datkinson/dissertation/report/Images/ir.jpg

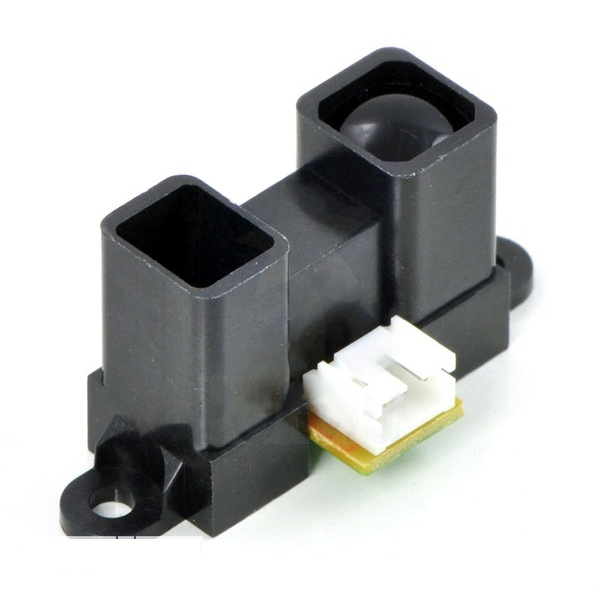
report/Images/ir.jpg
