datkinson/dissertation/report/Images/lr-ir.jpg

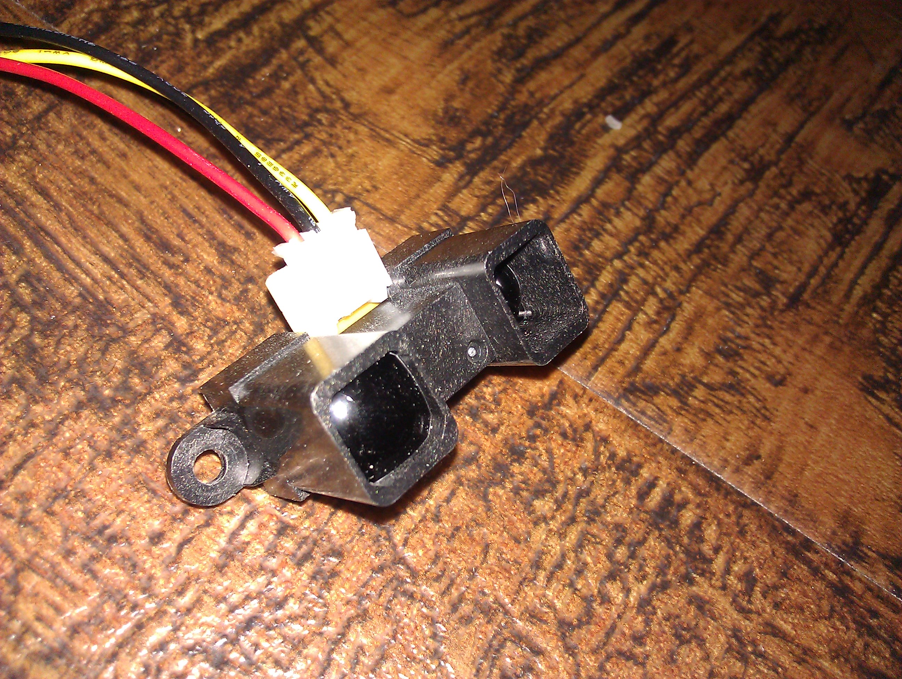
report/Images/lr-ir.jpg
