datkinson/dissertation/README.md

dissertation
============

Final year project
