datkinson/dissertation/report/abstract.tex

\thispagestyle{empty}

\begin{center}
    {\LARGE\bf Abstract}
\end{center}
The aim of this project is to physically build and write the software for a robot.  This robot should be able to drive around within its environment under its own power without colliding with any obstruction.  It should also be able to see areas of the environment using some form of sensor system in order to determine which direction to travel safely.
