datkinson/dissertation/report/Appendix2/appendix2.tex

\chapter{Code samples}

\section{Motor control}
Motors moving forward using stepper library and h-bridge.
\lstinputlisting{Code/motors-old.cpp}

Motors moving forward using replacement Pololu stepper drivers.
\lstinputlisting{Code/motors-new.cpp}

\section{Sonar}
Trigger and echo control of the sonar sensors.
\lstinputlisting{Code/sonar.cpp}
