datkinson/dissertation/report/cover.tex

\title{Arduino Based Obstacle Avoidance Robot}

% Your name
\author{Daniel Atkinson}

% Your email
\authoremail{daa9@aber.ac.uk}

\degreeschemecode{G401} %e.g. G400
\degreeschemetitle{Computer Science} % e.g. Computer Science
\degreetype{BSc}

\modulecode{CS39440} % i.e. CS39440, CC39440, CS39620
\moduletitle{Major Project} % i.e. Major Project or Minor Project

\date{20th April 2013} % i.e. the date of this version of the report

\status{Release} % Use draft until you create the release version. Then, change this to Release.
\version{1.0}

%The title and name of your supervisor.
\supervisor{Prof. Dave Barnes}

%The email for your supervisor.
\supervisoremail{dpb@aber.ac.uk}

\maketitle
