datkinson/dissertation/disc/videos/1 - prototype chassis/FirstFrame.png

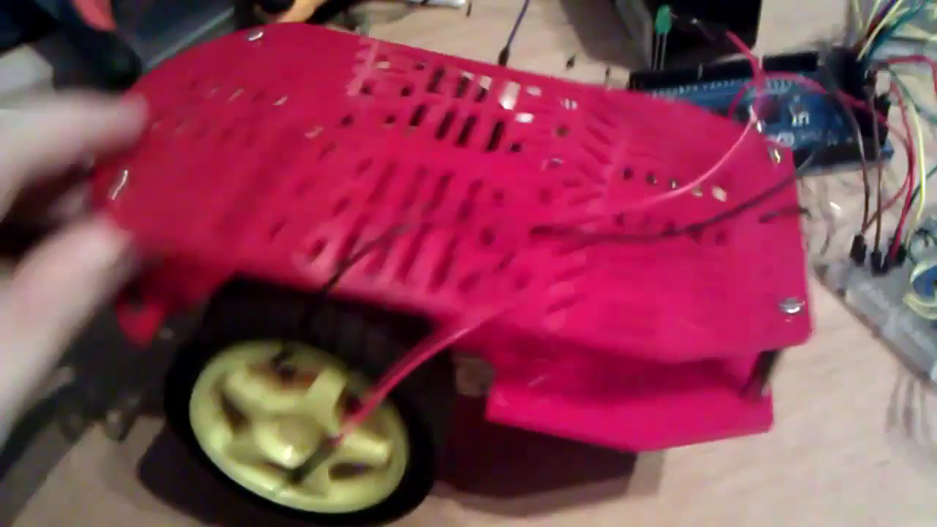
disc/videos/1 - prototype chassis/FirstFrame.png
