datkinson/dissertation/disc/videos/2 - prototype demonstration/FirstFrame.png

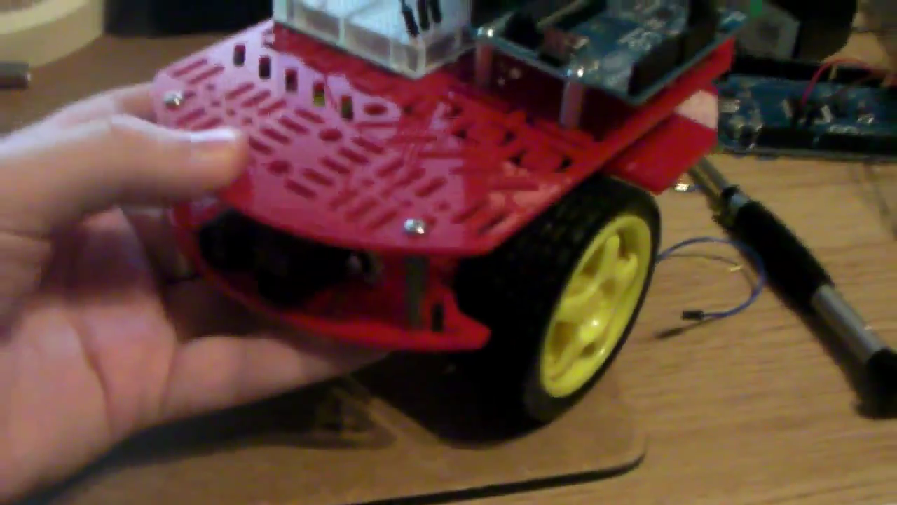
disc/videos/2 - prototype demonstration/FirstFrame.png
