datkinson/dissertation/disc/videos/3 - stepper motors/FirstFrame.png

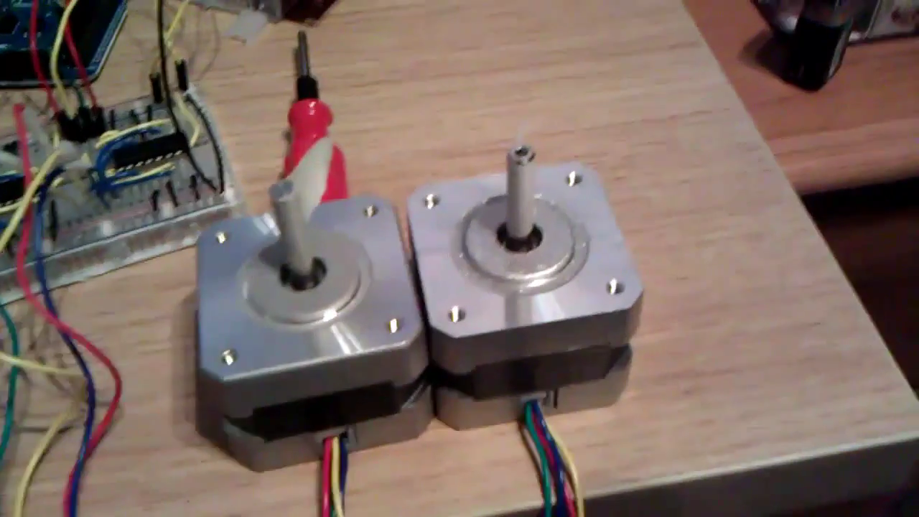
disc/videos/3 - stepper motors/FirstFrame.png
