datkinson/dissertation/disc/videos/5 - feedback device/FirstFrame.png

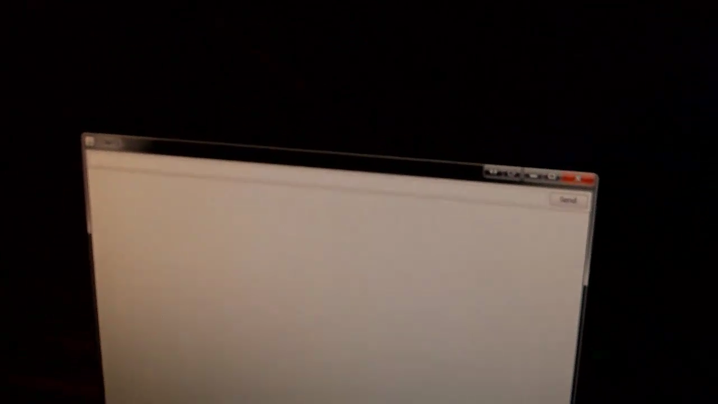
disc/videos/5 - feedback device/FirstFrame.png
