datkinson/dissertation/disc/videos/6 - drive demo/FirstFrame.png

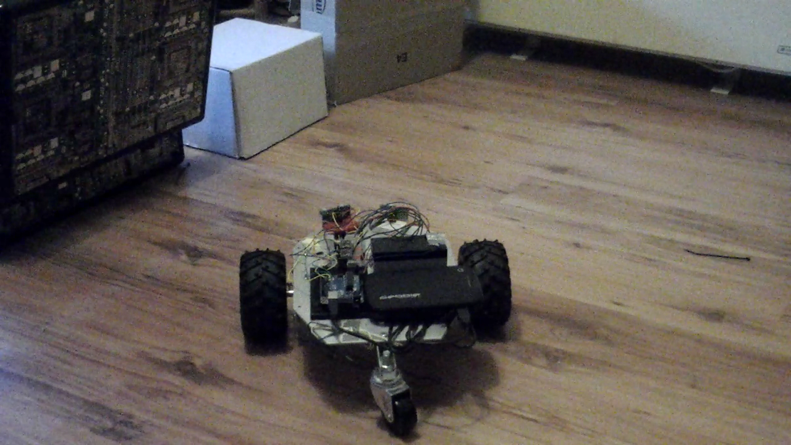
disc/videos/6 - drive demo/FirstFrame.png
