datkinson/dissertation/report/Images/2-wheel-side.gif

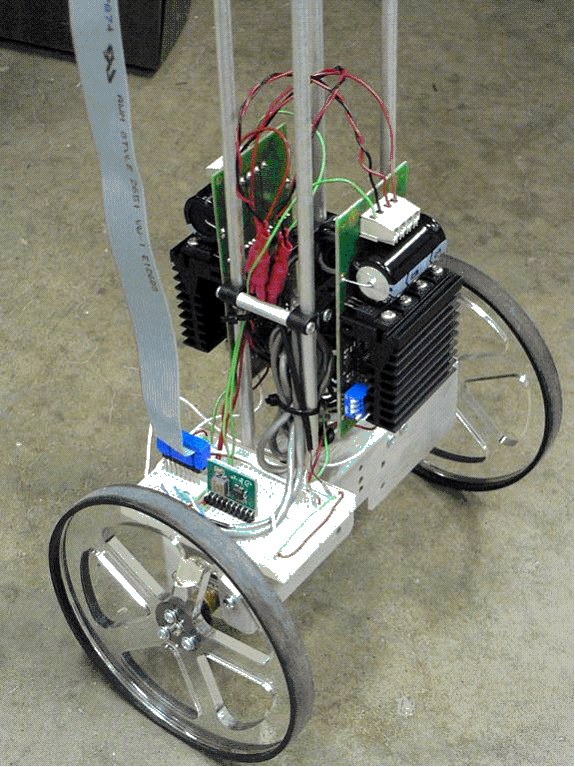
report/Images/2-wheel-side.gif
