datkinson/dissertation/report/Images/advanced-uml.png

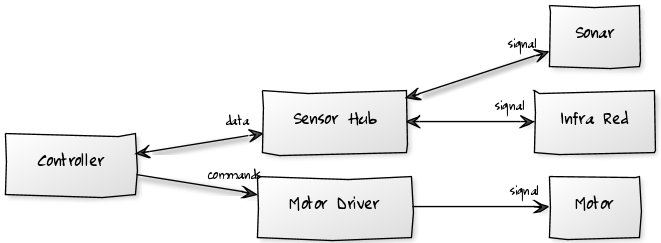
report/Images/advanced-uml.png
