datkinson/dissertation/report/Images/alu-cut-1.jpg

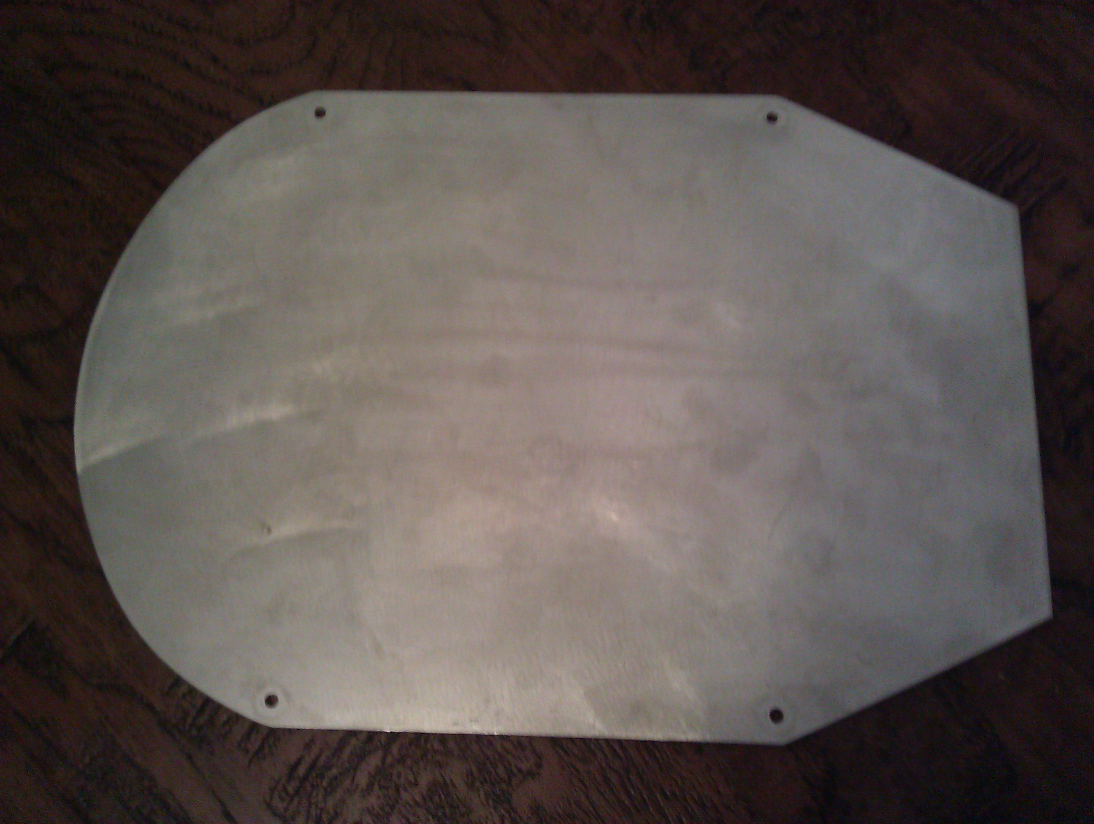
report/Images/alu-cut-1.jpg
