datkinson/dissertation/report/Images/alu-cut-2.jpg

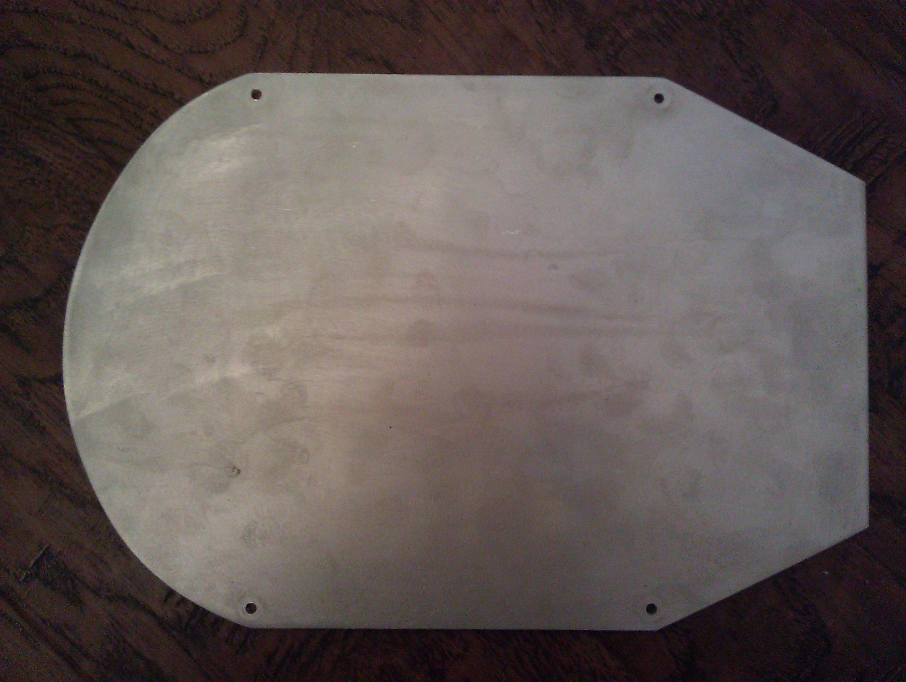
report/Images/alu-cut-2.jpg
