datkinson/dissertation/report/Images/alu-sheet-1.jpg

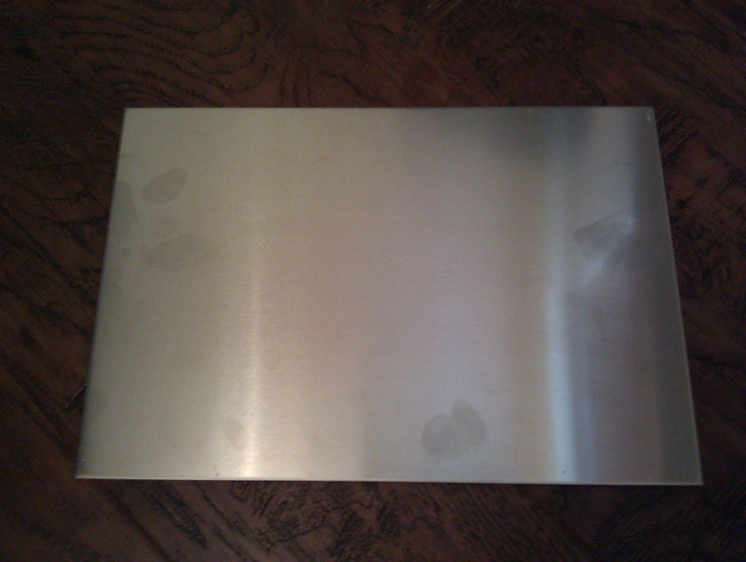
report/Images/alu-sheet-1.jpg
