datkinson/dissertation/report/Images/alu-sheet-2.jpg

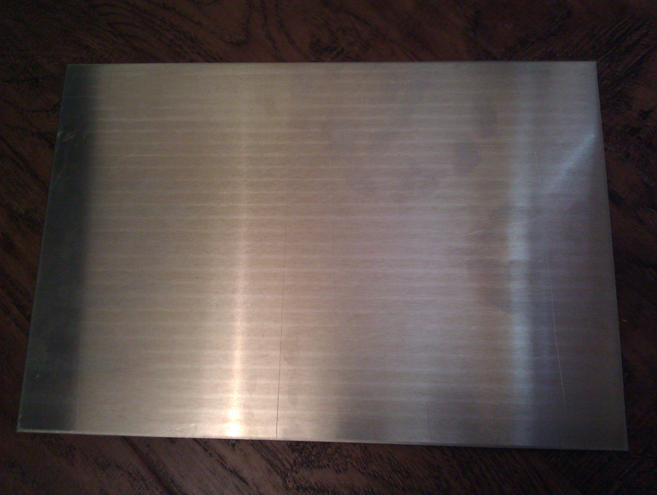
report/Images/alu-sheet-2.jpg
