datkinson/dissertation/report/Images/bluetooth.jpg

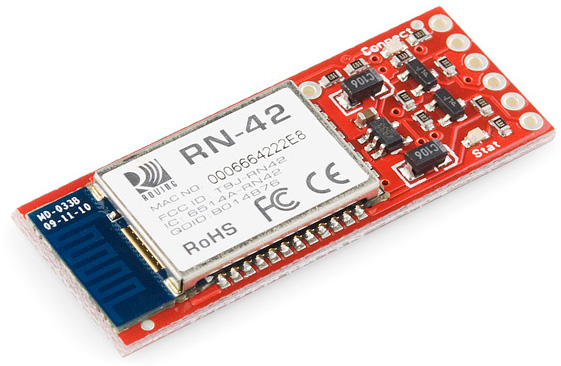
report/Images/bluetooth.jpg
