datkinson/dissertation/report/Images/CameraZOOM-20130420165930423.jpg

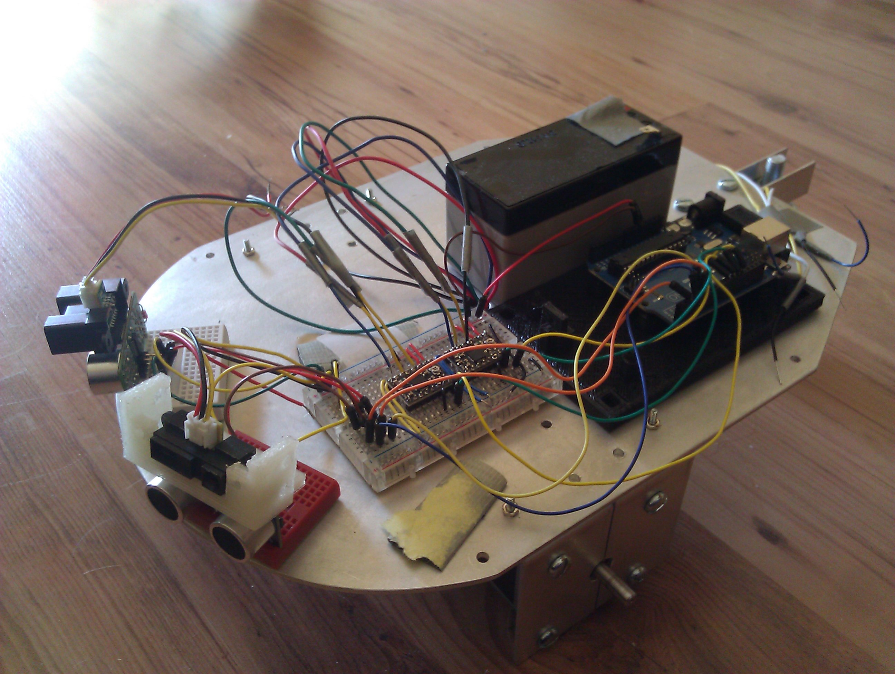
report/Images/CameraZOOM-20130420165930423.jpg
