datkinson/dissertation/report/Images/CameraZOOM-20130420170006403.jpg

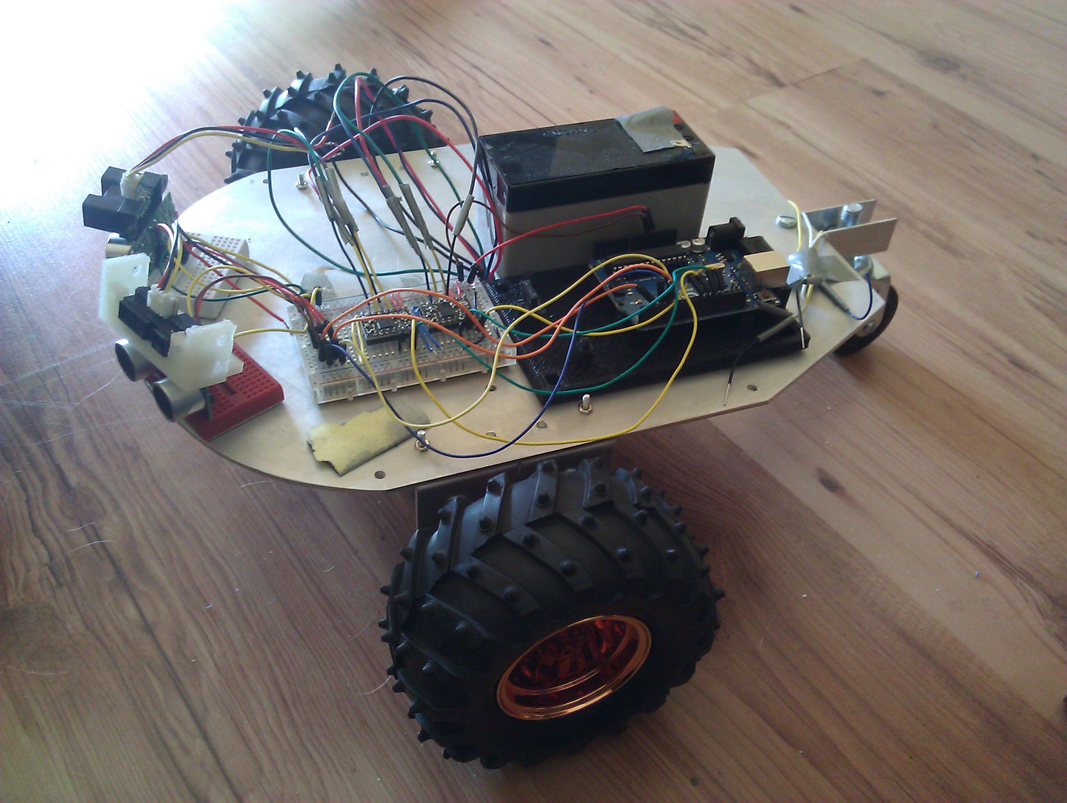
report/Images/CameraZOOM-20130420170006403.jpg
