datkinson/dissertation/report/Images/colson.jpg

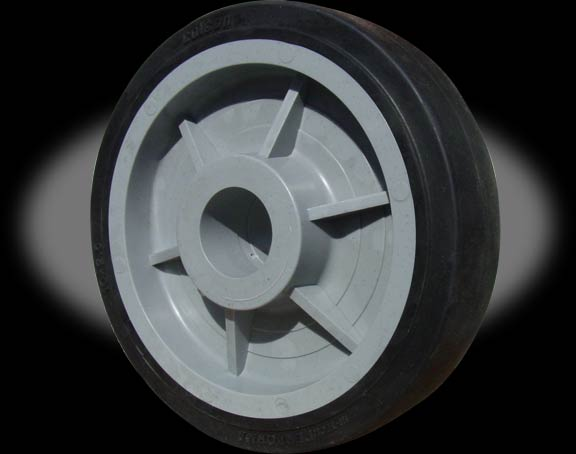
report/Images/colson.jpg
