datkinson/dissertation/report/Images/e-ink-display.png

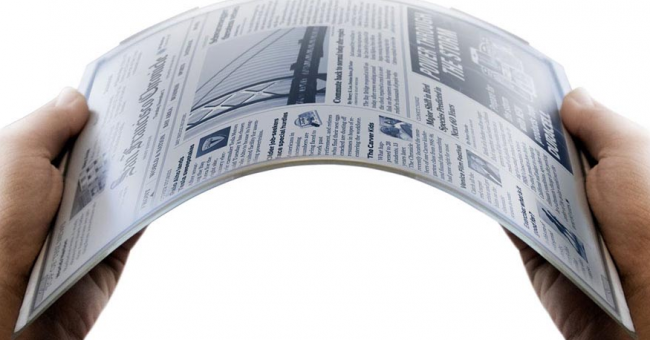
report/Images/e-ink-display.png
