datkinson/dissertation/report/Images/lcd.jpg

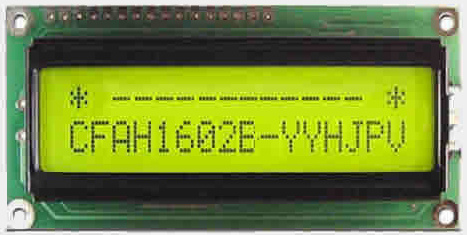
report/Images/lcd.jpg
