datkinson/dissertation/report/Images/lipo.jpg

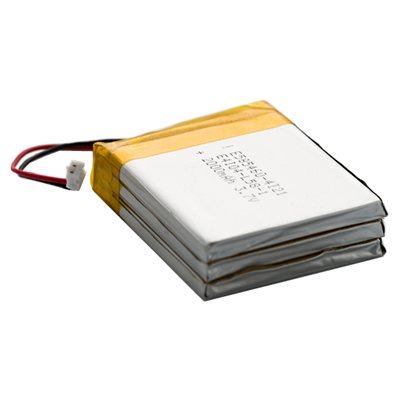
report/Images/lipo.jpg
