datkinson/dissertation/report/Images/mechanum.jpg

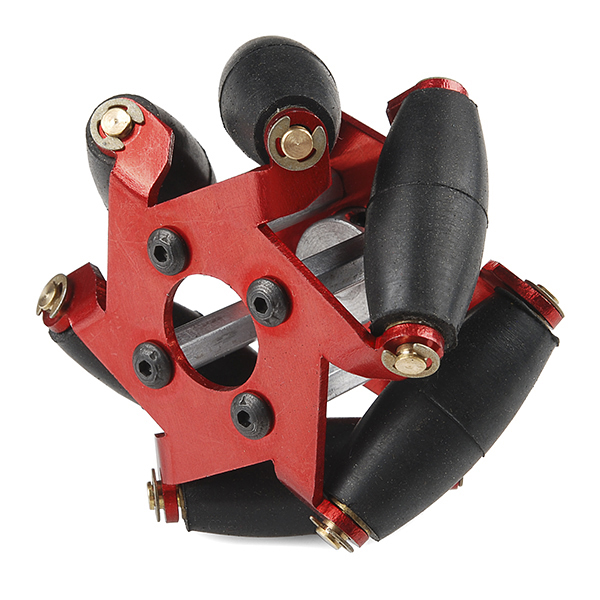
report/Images/mechanum.jpg
