datkinson/dissertation/report/Images/mk-vi.jpg

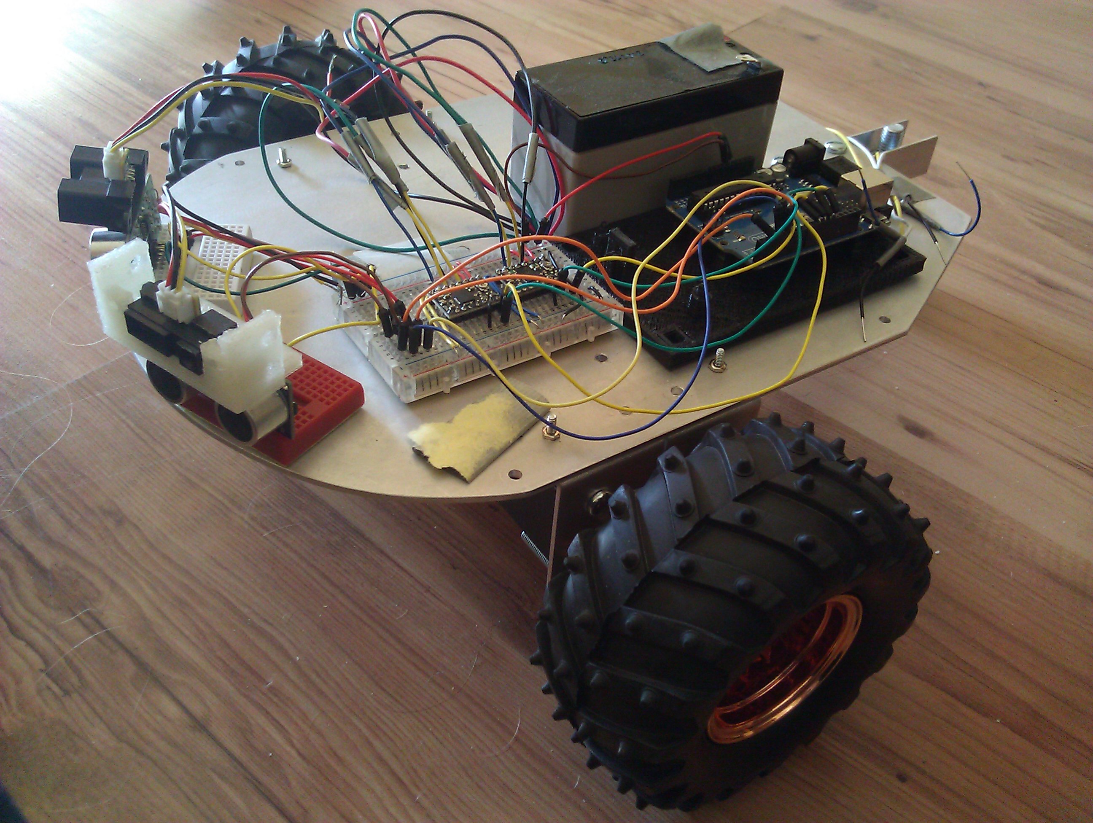
report/Images/mk-vi.jpg
