datkinson/dissertation/report/Images/motor-compare-back.jpg

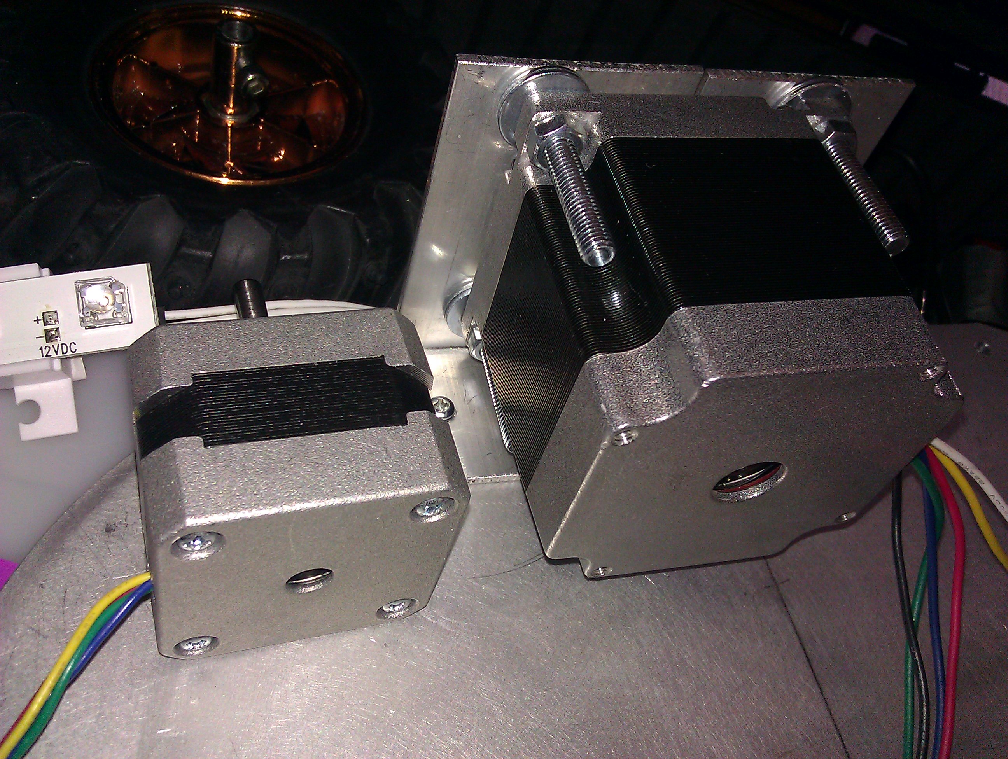
report/Images/motor-compare-back.jpg
