datkinson/dissertation/report/Images/motor-compare.jpg

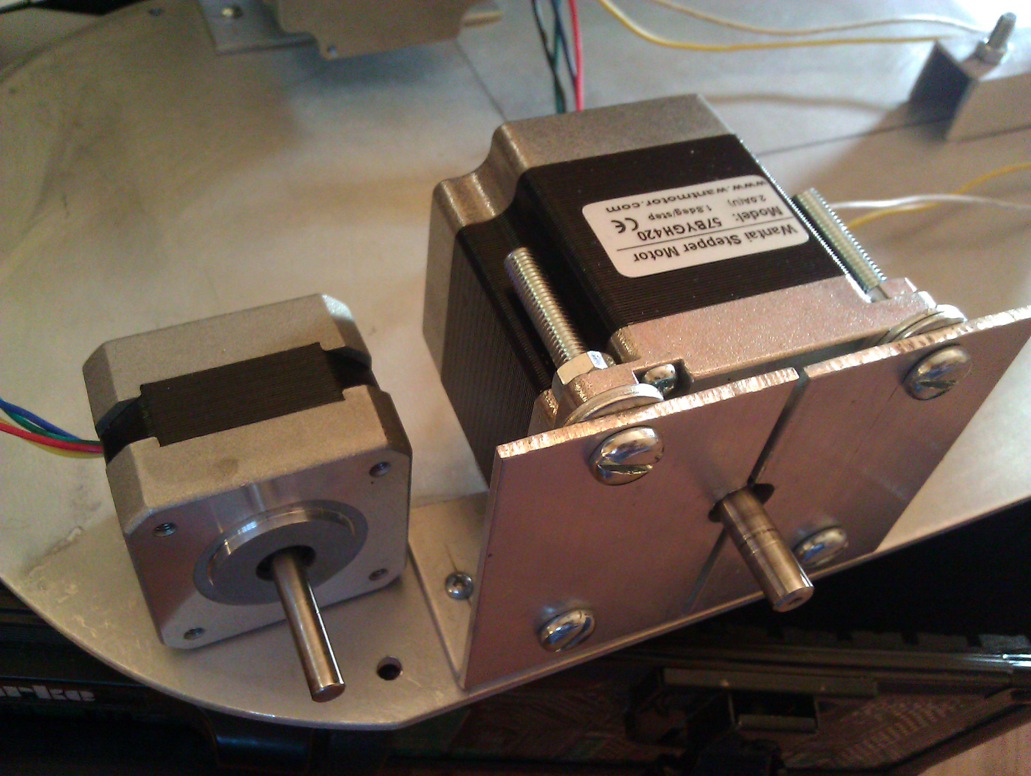
report/Images/motor-compare.jpg
