datkinson/dissertation/report/Images/motor-mount-1.jpg

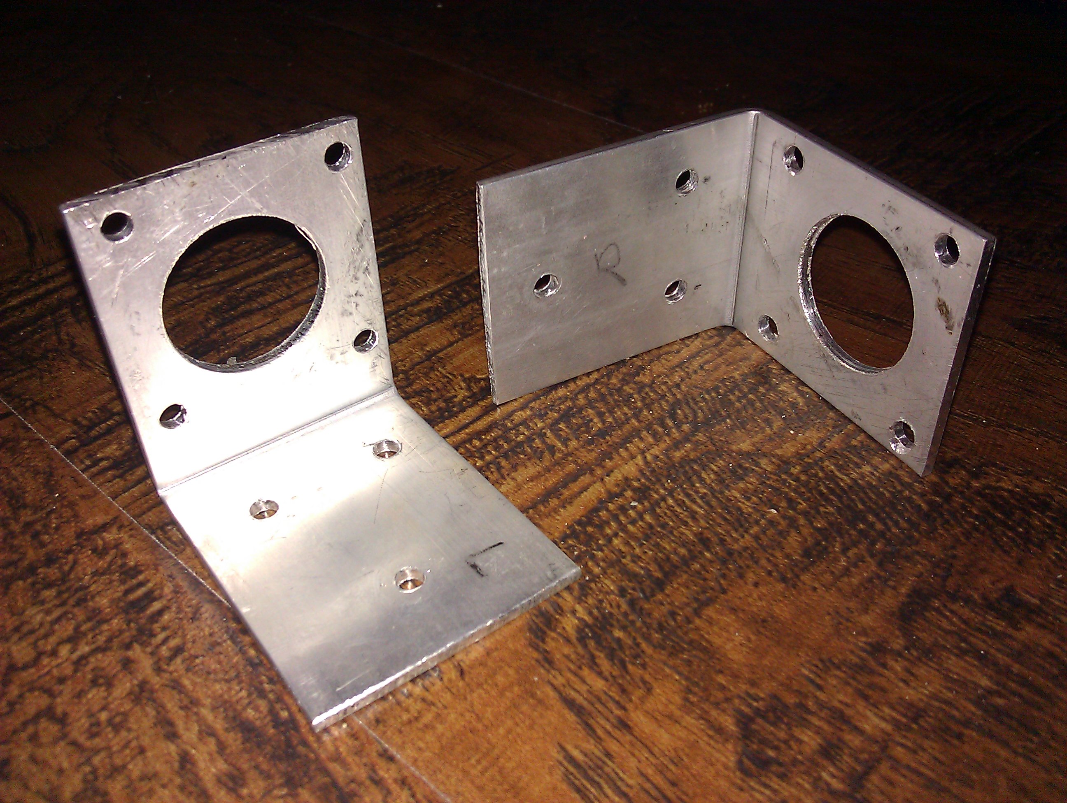
report/Images/motor-mount-1.jpg
