datkinson/dissertation/report/Images/nao.jpg

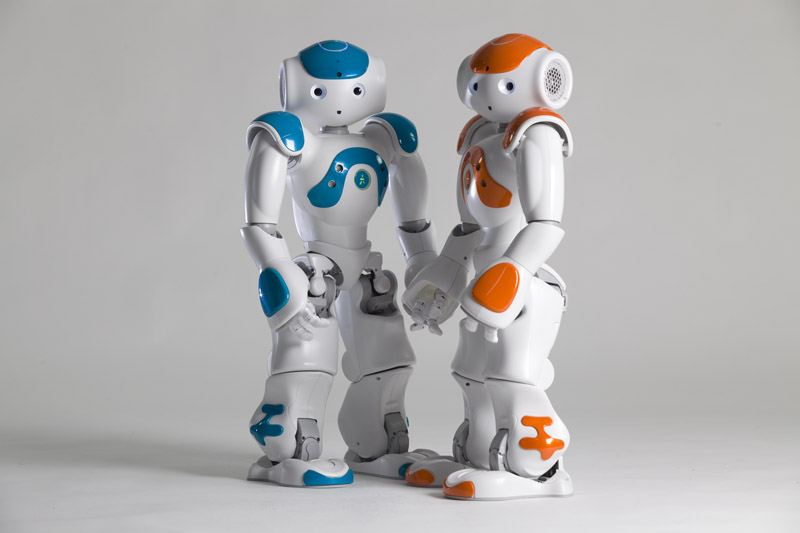
report/Images/nao.jpg
