datkinson/dissertation/report/Images/netduino.png

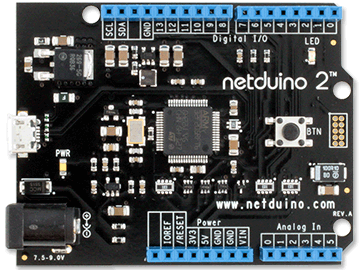
report/Images/netduino.png
