datkinson/dissertation/report/Images/pololu-motor-driver.jpg

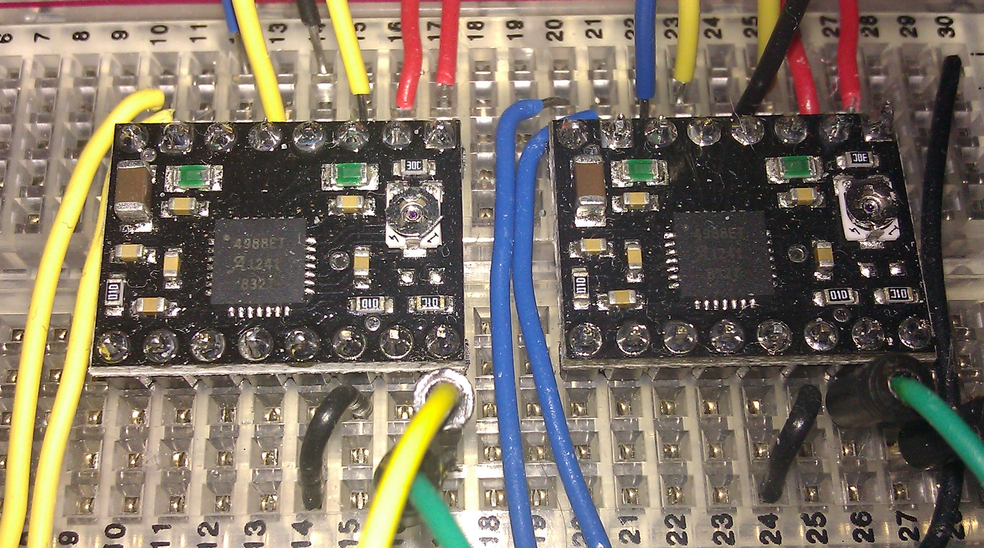
report/Images/pololu-motor-driver.jpg
