datkinson/dissertation/report/Images/second-design.png

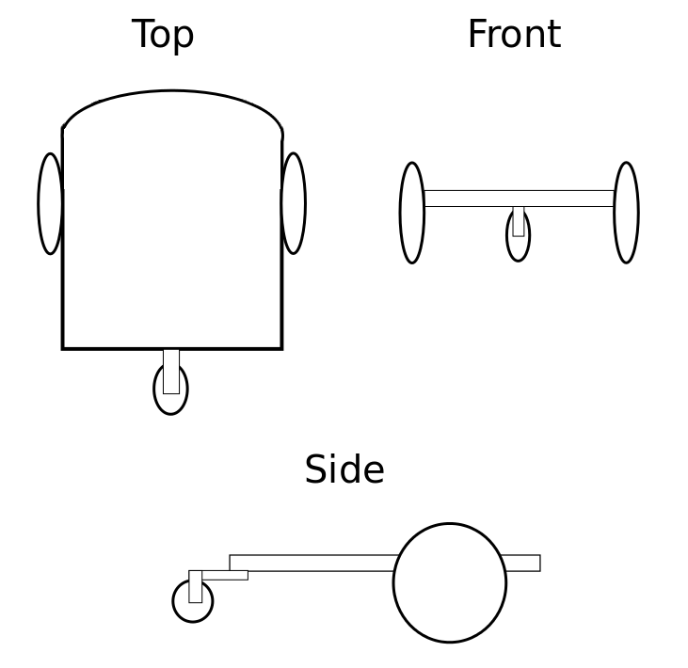
report/Images/second-design.png
