datkinson/dissertation/report/Images/small-stepper.jpg

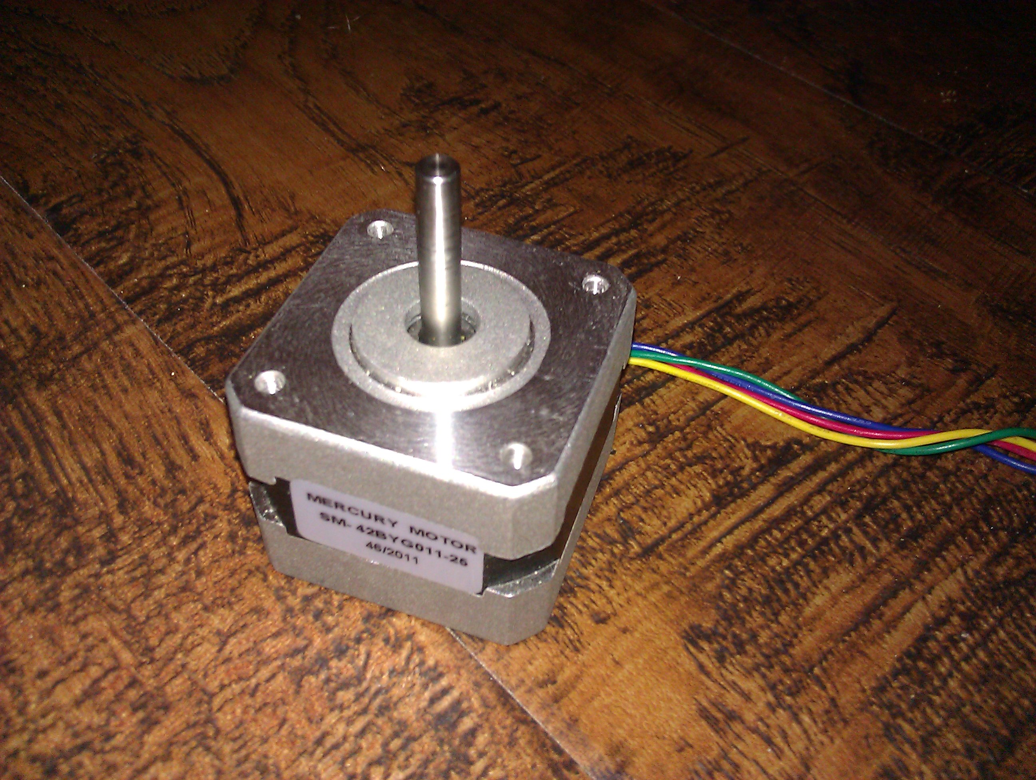
report/Images/small-stepper.jpg
