datkinson/dissertation/report/Images/sonar-placement.png

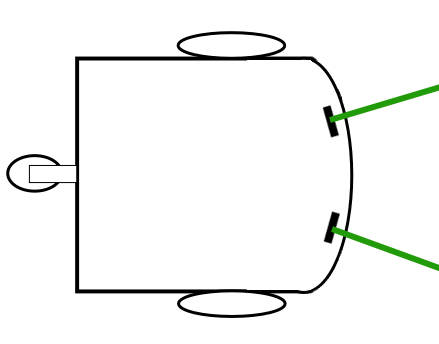
report/Images/sonar-placement.png
