datkinson/dissertation/report/Images/sonar-range.png

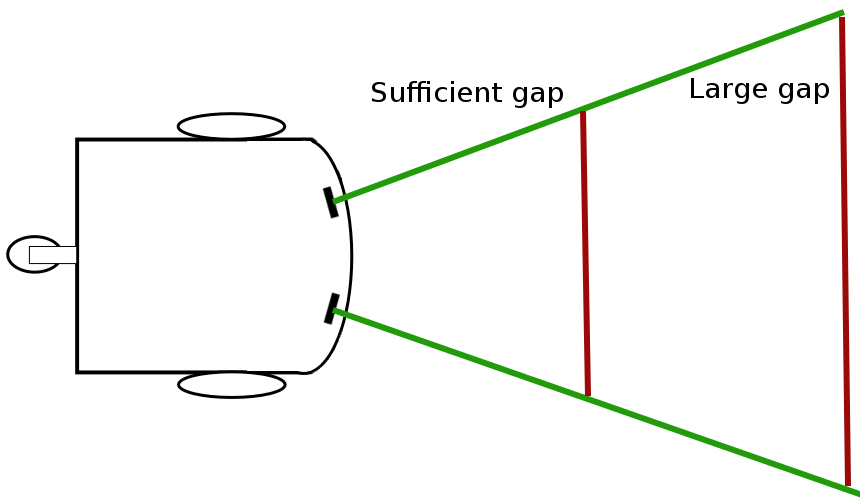
report/Images/sonar-range.png
