datkinson/dissertation/report/Images/svn-branching.png

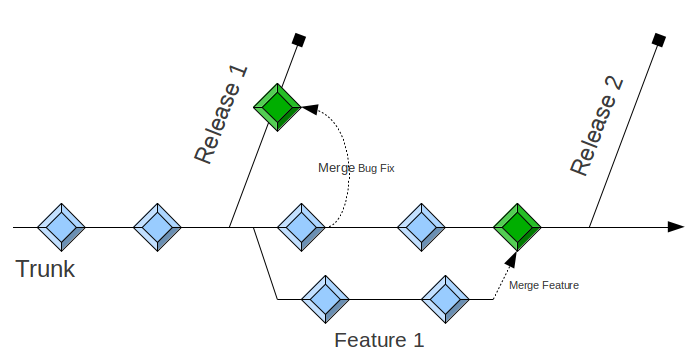
report/Images/svn-branching.png
