datkinson/dissertation/report/Images/usb-wifi.jpg

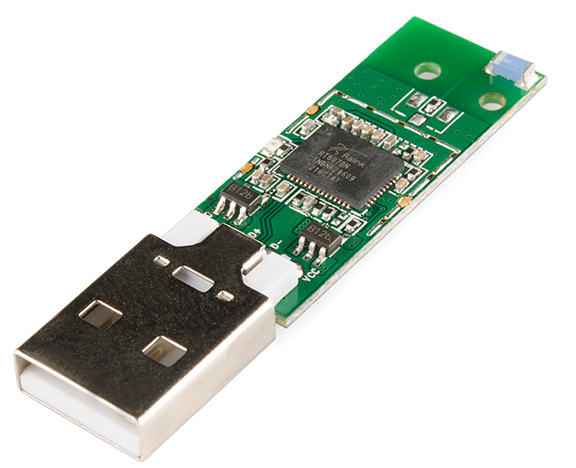
report/Images/usb-wifi.jpg
