datkinson/dissertation/report/Images/wheel-offroad.jpg

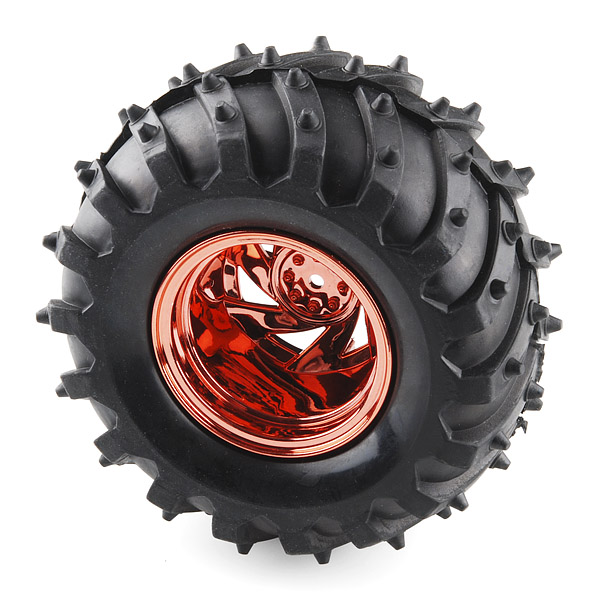
report/Images/wheel-offroad.jpg
