datkinson/dissertation/report/Images/wheel-thin.jpg

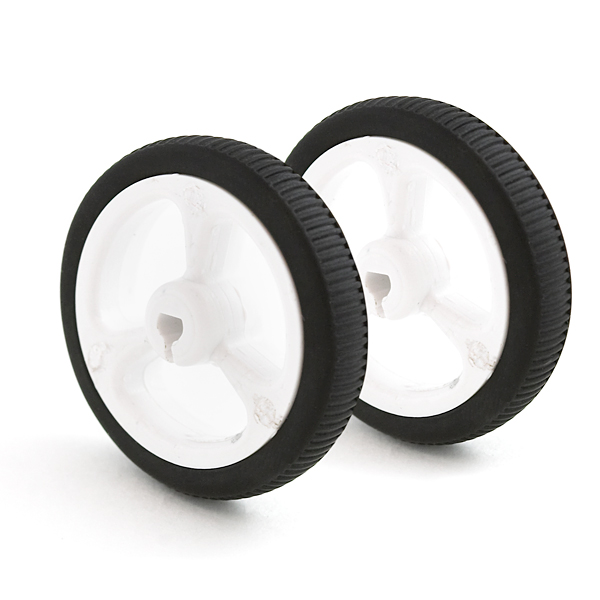
report/Images/wheel-thin.jpg
