datkinson/dissertation/report/Images/wheel-track.jpg

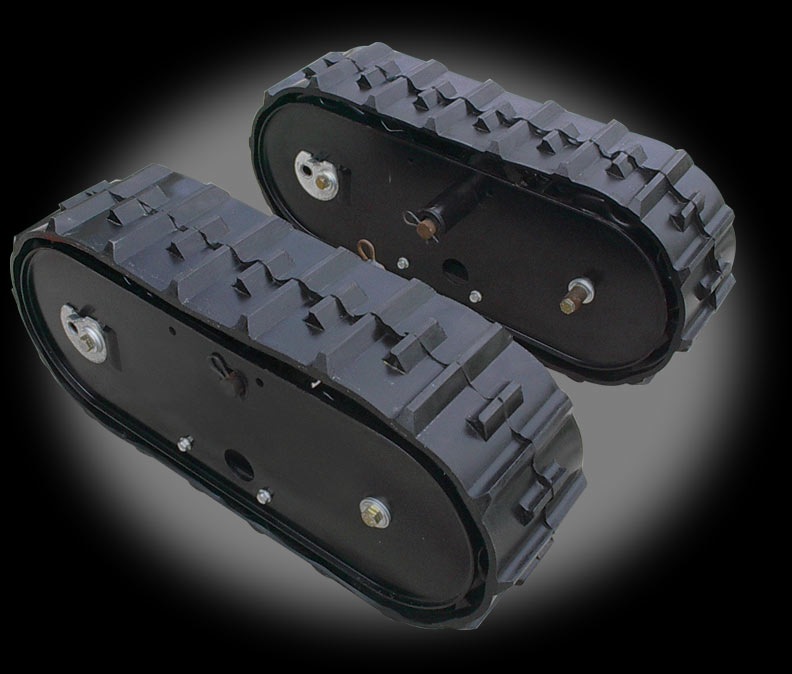
report/Images/wheel-track.jpg
