datkinson/dissertation/report/Images/wifi-module.jpg

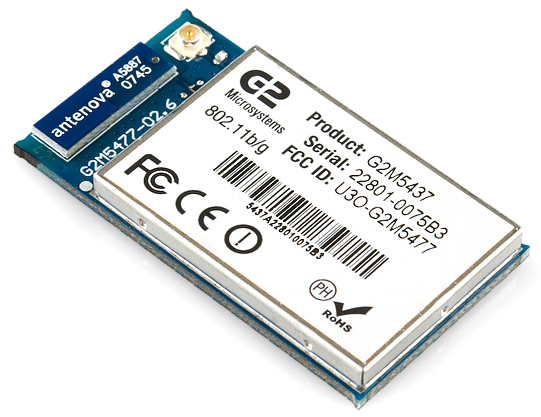
report/Images/wifi-module.jpg
