datkinson/dissertation/report/Images/xbee.jpg

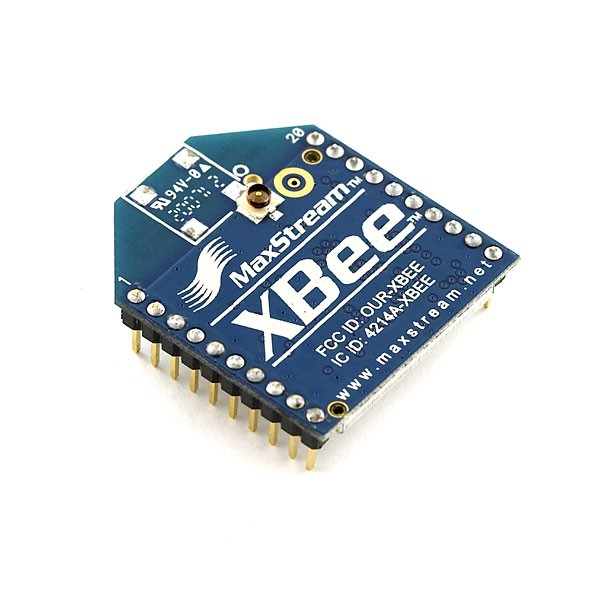
report/Images/xbee.jpg
