datkinson/dissertation/disc/videos/4 - metal construction/FirstFrame.png

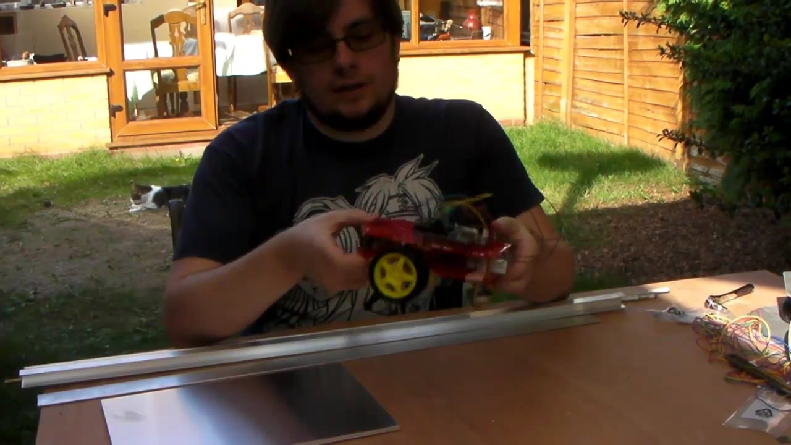
disc/videos/4 - metal construction/FirstFrame.png
