datkinson/dissertation/disc/videos/7 - 3d printing/FirstFrame.png

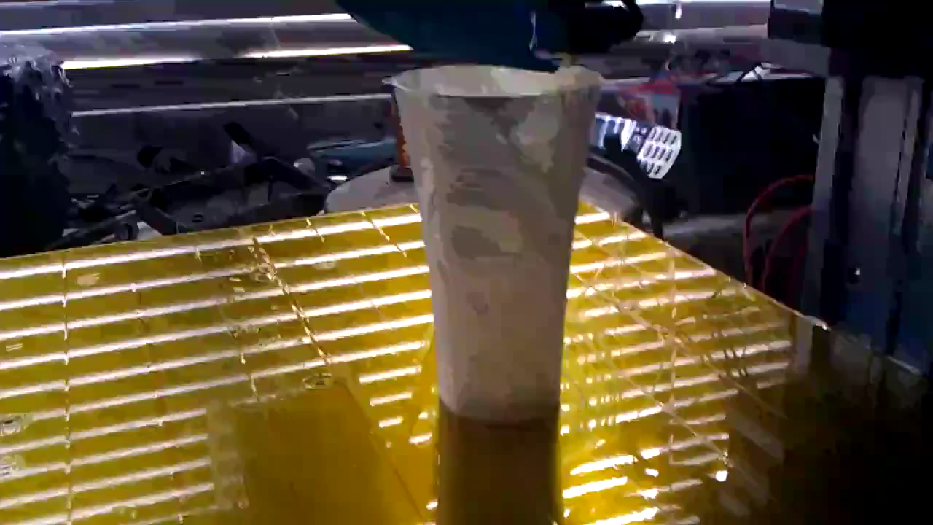
disc/videos/7 - 3d printing/FirstFrame.png
