datkinson/dissertation/report/Images/print-aircraft.jpg

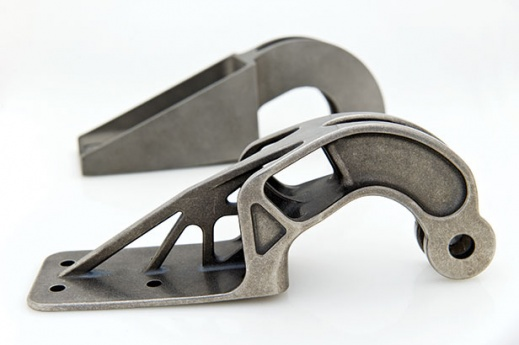
report/Images/print-aircraft.jpg
