datkinson/dissertation/report/Images/printed-sensor-mounts.jpg

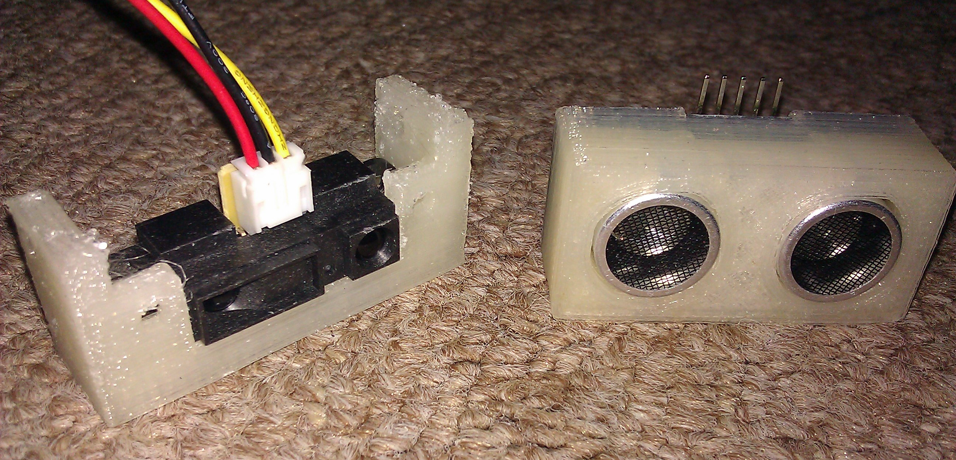
report/Images/printed-sensor-mounts.jpg
