datkinson/dissertation/report/Images/ir-measure-1.jpg

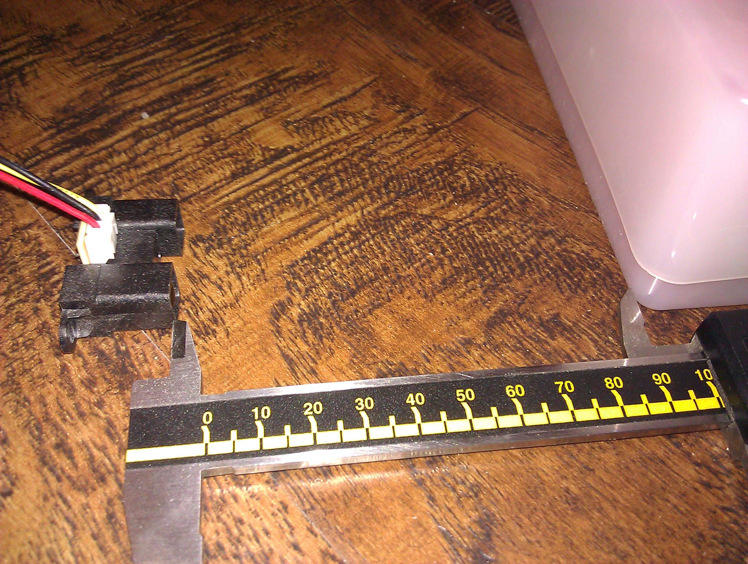
report/Images/ir-measure-1.jpg
