datkinson/dissertation/report/Images/ir-measure-2.jpg

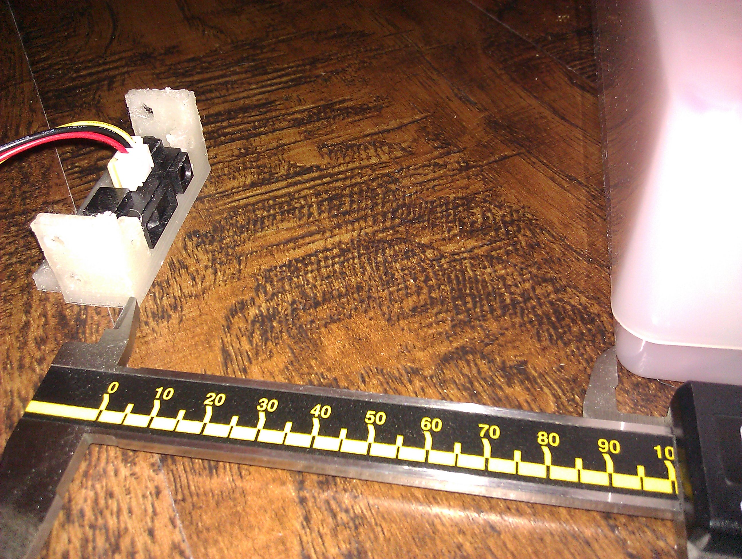
report/Images/ir-measure-2.jpg
