datkinson/dissertation/report/Code/main.cpp

/*
Author: Daniel Atkinson
Version: 1.1
Controlling stepper motors based on sonar sensor readings in a
reactive way
*/
#include <Stepper.h>
#define sonar1TrigPin 8
#define sonar1EchoPin 7
#define sonar2TrigPin 6
#define sonar2EchoPin 5

//initialise serial variable
int incomingData = 0;

//Global variables
int leftSonar, rightSonar;

//Magic Numbers
int arbritraryMovement = 50;
int motorDelay = 1000;
int proximityThreshold = 25;
int defaultDelay = 10;

void setup() {
  // initialize the serial port:
  Serial.begin(57600);
  //Set inputs and outputs of the first 2 sonar modules
  pinMode(sonar1TrigPin, OUTPUT);
  pinMode(sonar1EchoPin, INPUT);
  pinMode(sonar2TrigPin, OUTPUT);
  pinMode(sonar2EchoPin, INPUT);
}

void loop() {
  detectProximity();
  if(validateSonar){
    reactiveSonar(leftSonar, rightSonar);
  }
}

void reactiveSonar(int left, int right){
  if(left < proximityThreshold && right < proximityThreshold){
    moveBackward(arbritraryMovement);
  }else{
    if(left < proximityThreshold){
      turnRight(arbritraryMovement);
    }else{
      if(right < proximityThreshold){
        turnLeft(arbritraryMovement);
      }else{
        moveForward(arbritraryMovement);
      }
    }
  }
}
