datkinson/dissertation/report/Code/sonar.cpp

/*
Example of sonar sending out a trigger pulse and
measuring how long it takes for the echo to come back
*/
int getSonarReading(int trigger, int echo){
  int duration, distance;
  digitalWrite(trigger, HIGH);
  delayMicroseconds(soundDelay);
  digitalWrite(trigger, LOW);
  duration = pulseIn(echo, HIGH);
  distance = (duration/2) / 29.1;
  return(distance);
}
