datkinson/dissertation/(commit log)

2013-04-07 Outlined tria prototype
2013-04-07 Basic description of prototype implementation
2013-04-09 prototype motor issue
2013-04-11 added motor to chassis
2013-04-11 3d printer summary
2013-04-11 printed mount figure addition
2013-04-21 evaluation - sensors
